s19a1k11/SmartHome_v21/串口测试命令手册.md

# 串口调试助手 测试命令手册（v22）

> 全部命令**从代码实际实现提取**，逐条核对过，可直接复制粘贴。
> 文件：`MASTER/user/api/cli.c` + `cloud.c`

---

## 一、串口设置（必须对）

| 项 | 值 | 说明 |
|---|---|---|
| 串口号 | 接 **PA9/PA10** 的那个 | 主机调试口 |
| 波特率 | **9600** | ⚠️ 不是 115200 |
| 数据位 | 8 | |
| 停止位 | 1 | |
| 校验位 | NONE | |
| **发送模式** | **ASCII** | ⚠️ 不是 HEX |
| 接收模式 | ASCII | |
| 加回车换行 | 建议勾选 | 不勾也能用（靠 IDLE 判帧） |

**发送切 HEX 会全部失败**——那是给 ModBus 原始帧调试用的。

---

## 二、本地诊断命令（`@` 开头）

### 2.1 总览类

```
@help
```
列出所有命令。**第一个该敲的命令。**

```
@version
```
打印固件版本和关键配置。预期输出：
```
[CLI] fw=2026-10-24-v21 MASTER slaves=2
[CLI] reply_timeout=250ms upload=15s modbus_log=0
```

```
@stat
```
**最常用**。打印两台从机的完整状态：
```
[CLI] ===== slaves =====
[CLI] #1 addr=1 ONLINE err=0 dErr=0
[CLI]    T=24.2 H=31.0 Lux=3719
[CLI]    LED=0 BEEP=0 SERVO=1 run=125s
[CLI] #2 addr=2 ONLINE err=0 dErr=0
[CLI]    T=26.8 H=36.0 Lux=3720
[CLI]    LED=0 BEEP=0 SERVO=1 run=98s
[CLI] SR602=0 LuxAvg=3718 Night=0 led1=0
```

### 2.2 硬件诊断类

```
@esp
```
诊断 ESP8266。会打印引脚电平 + 主动发一次 `AT` + 原始回包：
```
[CLI] CH_PD(PA4)=1 GPIO0(PA15)=1
[CLI] esp got=6B raw=[\r\nOK\r\n]
[CLI] ESP alive (got OK)
```

```
@sr602
```
人体感应状态：
```
[CLI] SR602=0 (1=human) LuxAvg=3718 Night=0
```
**手在模块前晃一下**，再敲一次应该变 `SR602=1`。

```
@lcd
```
**屏幕自检**。依次刷纯红 → 纯绿 → 纯蓝 → 恢复界面（每个 0.6 秒）。

| 现象 | 判断 |
|---|---|
| 三色都能看到 | 屏幕和接线正常 |
| 只有白/黑 | SPI 没通，查 PA5/PA7/CS/DC |

### 2.3 动作测试类

```
@poll
```
立刻轮询一次全部从机（不等 1 秒节拍），然后打印状态。

```
@upload
```
立刻上报一次云端（不等 15 秒节拍）。成功后串口会看到 `[CLOUD] up: {...}`。

```
@autolight on
```
强制打开 1 号从机的灯（绕过夜晚判定）。**测灯最直接的方法。**
```
[CLI] led1 forced ON
```

```
@autolight off
```
强制关闭 1 号从机的灯。

### 2.4 调试开关类

```
@log on
```
打开逐帧 ModBus 日志。之后每笔事务都会打原始帧：
```
TX[08]: 01 03 00 00 00 04 44 09
RX[13]: 01 03 08 01 02 00 00 00 00 00 00 77 DB
```
**⚠️ 打开后轮询会明显变慢**（实测日志吃掉约 89% 的串口带宽），调完记得关。

```
@log off
```
关闭逐帧日志，恢复正常速度。

---

## 三、模拟云端下发命令（JSON）

这些命令走的是**和云端下发完全相同**的函数 `Cloud_Handle_Downlink()`。
所以**串口能通 = 云端一定能通**。

### 3.1 灯控制（最常用）

```
{"Led1":true}
```
1 号从机开灯。预期：
```
[CLI] rx: {"Led1":true}
[CLI] -> Cloud_Handle_Downlink
[CLOUD] down: {"Led1":true}
[CLOUD] led#1 ON ok
```

```
{"Led1":false}
```
1 号从机关灯。

```
{"Led2":true}
```
2 号从机开灯。

```
{"Led2":false}
```
2 号从机关灯。

### 3.2 蜂鸣器

```
{"Beep1":true}
```
1 号蜂鸣器响。

```
{"Beep1":false}
```
1 号蜂鸣器停。

```
{"Beep2":true}
```

```
{"Beep2":false}
```

### 3.3 舵机

```
{"SG90_1":"clockwise"}
```
1 号舵机顺时针 = **180 度**（档位 2）。

```
{"SG90_1":"counter_clockwise"}
```
1 号舵机逆时针 = **0 度**（档位 0）。

```
{"SG90_2":"clockwise"}
```

```
{"SG90_2":"counter_clockwise"}
```

**也兼容数字档位**（0/1/2）：
```
{"SG90_1":0}
{"SG90_1":1}
{"SG90_1":2}
```
对应 0° / 90° / 180°。

### 3.4 总使能开关

```
{"stm32":true}
```
总使能开（默认就是开）。

```
{"stm32":false,"Led1":true}
```
总使能关 → **整条命令被忽略**，灯不会亮。预期：
```
[CLOUD] stm32 disabled, drop cmd
```
**用来验证总使能逻辑。**

### 3.5 组合命令

一条命令做多件事：
```
{"Led1":true,"Beep1":true,"SG90_1":"clockwise"}
```
```
{"Led1":false,"Led2":true,"Beep2":true}
```
```
{"stm32":true,"Led1":true,"Led2":true}
```

---

## 四、按测试目标组织的测试序列

### 测试 1：验证串口和 CLI 活着

```
@version
```
看到 `v21` 和 `slaves=2` → 通过。

### 测试 2：验证两台从机在线

```
@stat
```
看到两台都是 `ONLINE` 且温湿度光照有真实数据 → 通过。

### 测试 3：验证灯控制（1 号）

```
{"Led1":true}
```
**看 1 号从机板上的红色 LED（PB5/DS0）是否亮起。**

```
{"Led1":false}
```
灯灭 → 通过。

如果打 `[CLOUD] led#1 ON ok` 但灯不亮，是硬件问题（查从机板 LED）。

### 测试 4：验证舵机

```
{"SG90_1":"clockwise"}
```
舵机转到 180 度。

```
{"SG90_1":"counter_clockwise"}
```
舵机转到 0 度 → 通过。

### 测试 5：验证蜂鸣器

```
{"Beep1":true}
```
响。等 2 秒。

```
{"Beep1":false}
```
停 → 通过。

### 测试 6：验证总使能

```
{"stm32":false,"Led1":true}
```
预期灯**不亮**，串口打 `stm32 disabled, drop cmd`。

```
{"stm32":true,"Led1":true}
```
预期灯亮 → 通过。

### 测试 7：验证 SR602 人体感应

```
@sr602
```
记下当前值（应该 `SR602=0`）。

**手在 SR602 模块前晃 2 秒**，再敲：
```
@sr602
```
应该变 `SR602=1` → 通过。

### 测试 8：验证夜晚自动开灯

**方法 A：临时改阈值（能测完整逻辑）**

改 `MASTER/user/api/autolight.h`：
```c
#define NIGHT_LIGHT_THRESHOLD (4000)   // 临时：白天也算夜晚
```
重新编译烧录。然后：
1. 手在 SR602 前晃 → `human=1` 且 `night=1` → **灯自动亮**
2. 手拿开 → 等 **10 秒** → **灯自动灭**

日志：
```
[AUTO] human left, start timer
[AUTO] led off
```

**测完记得改回 1500。**

**方法 B：用 CLI 强制开（不测自动逻辑，只测灯）**
```
@autolight on
```

### 测试 9：验证云端上报

```
@upload
```
预期串口打出完整 JSON：
```
[CLOUD] up: {"Temp1":24.2,"Hum1":31.0,"Lux1":3719,"Led1":false,"Bp1":false,
"SenErr1":false,"Temp2":26.8,"Hum2":36.0,"Lux2":3720,"Led2":false,
"Bp2":false,"SenErr2":false,"SR602":0,"LuxAvg":3718,"Night":0,
"Online1":true,"Online2":true}
```

然后去 ThingsCloud 平台看属性面板是否刷新。

### 测试 10：验证 ModBus 原始帧

```
@log on
```
等 3 秒，会看到：
```
TX[08]: 01 03 00 00 00 04 44 09
RX[13]: 01 03 08 01 02 00 00 00 00 00 00 77 DB
```
**用 ModBus 调试工具或手册核对 CRC。**

```
@log off
```
恢复。

### 测试 11：验证屏幕

```
@lcd
```
三色 + 界面 → 通过。

### 测试 12：验证 ESP8266

```
@esp
```
预期 `got=6B raw=[\r\nOK\r\n]` + `ESP alive`。

---

## 五、错误提示对照表

| 串口输出 | 含义 | 怎么修 |
|---|---|---|
| `[CLI] not a command: need '{' (json) or '@' (local)` | 输入格式不对 | JSON 以 `{` 开头，本地命令以 `@` 开头 |
| `[CLI] unknown cmd: @xxx` | 命令名拼错 | 敲 `@help` |
| `[CLOUD] !! NO KEY MATCHED` | JSON 键名不对 | 键名**区分大小写**，用 `Led1` 不是 `LED1` |
| `[CLOUD] stm32 disabled, drop cmd` | 总使能是 false | 正常行为 |
| `[CLOUD] led#1 DROPPED: slave offline` | 从机离线 | 先 `@stat` 看在线状态 |
| `[CLOUD] led#1 ON WRITE FAIL stat=1` | ModBus 写超时 | 查 485 接线 / 从机供电 |
| `[CLOUD] led#1 ON WRITE FAIL stat=2` | CRC 错 | 总线干扰 / 没共地 |
| `[CLOUD] led#1 ON WRITE FAIL stat=6` | 从机拒绝 | 值越界（不该发生） |
| `[MB] TIMEOUT addr=N` | 从机不应答 | 该从机没上电 / 地址不对 |
| `[MB] CRC FAIL` | 收到的帧 CRC 错 | 485 干扰 / T3.5 时序 |
| `[ESP] no 'OK' got=0B` | 模块没回任何字节 | 查 PB10→RX、PB11→TX、3.3V |
| `[CLOUD] no connack` | MQTT 凭据错 | 核对用户名密码 |
| `[CLOUD] PUBLISH DROPPED!` | 报文超长 | 不该发生（缓冲 512） |

---

## 六、一次性批量测试脚本（可选）

如果串口助手支持"循环发送"或"多条发送"，可以按这个顺序配：

**批次 1（灯）**
```
{"Led1":true}
{"Led1":false}
{"Led2":true}
{"Led2":false}
```

**批次 2（舵机）**
```
{"SG90_1":"clockwise"}
{"SG90_1":"counter_clockwise"}
{"SG90_2":"clockwise"}
{"SG90_2":"counter_clockwise"}
```

**批次 3（蜂鸣器）**
```
{"Beep1":true}
{"Beep1":false}
{"Beep2":true}
{"Beep2":false}
```

**批次 4（诊断）**
```
@stat
@sr602
@upload
```

---

## 七、JSON 格式硬规则（避免失败）

### 规则 1：键名区分大小写

| ✅ 正确 | ❌ 错误 |
|---|---|
| `Led1` | `LED1`、`led1`、`LED_1` |
| `Beep1` | `BEEP1`、`beep1` |
| `SG90_1` | `sg90_1`、`SG90-1` |
| `stm32` | `STM32`、`Stm32` |

### 规则 2：布尔值必须小写

```json
{"Led1":true}      ✅
{"Led1":True}      ❌
{"Led1":TRUE}      ❌
{"Led1":1}         ✅ 也兼容
{"Led1":0}         ✅ 也兼容
```

### 规则 3：舵机字符串必须带引号

```json
{"SG90_1":"clockwise"}      ✅
{"SG90_1":clockwise}        ❌ JSON 非法
{"SG90_1":2}                ✅ 数字档位也行
```

### 规则 4：单行长度上限 160 字符

`CLI_LINE_MAX = 160`。组合命令不要太长：

```
{"Led1":true,"Beep1":true,"SG90_1":"clockwise"}       45 字符  ✅
{"Led1":true,"Led2":true,"Beep1":true,"Beep2":true,"SG90_1":"clockwise","SG90_2":"counter_clockwise"}   103 字符  ✅
```

### 规则 5：不需要加空格

```
{"Led1":true}              ✅
{"Led1": true}             ✅ 也支持（代码会跳过空格）
{ "Led1" : true }          ✅ 也支持
```

---

## 八、最常用的 5 条（记住这些就够）

```
@stat                         看两台从机状态
@sr602                        看人体感应
{"Led1":true}                 开 1 号灯
{"Led1":false}                关 1 号灯
@lcd                          屏幕自检
```

---

*生成时间：2026-10-25 12:40*
*代码来源：`MASTER/user/api/cli.c` + `cloud.c`*
*所有命令均已在实际代码中核对，可直接使用*
