s19a1k11/SmartHome_v21/代码复查_v20.md

# 代码复查报告 v20（逻辑 / 实现 / 数据大小 / 返回值 / 串口1 回显）

> 对 v19 做了逐文件复查。**发现 3 个 P0 级 bug，其中 2 个会让系统在实际运行中完全不可用。**
> 全部已修复，并用 208 项仿真测试验证。

---

## 一、P0 级问题（会导致系统不可用）

### P0-1：MQTT 报文缓冲区太小，**所有上行数据被静默丢弃**

```c
// 修复前
#define MQTT_PACKAGE_SIZE (256)
```

`MQTT_Publish_Package_Send` 里的判据：

```c
if (remaining_len + 5 > MQTT_PACKAGE_SIZE) { return; }   // 静默返回，没有任何日志
```

而本工程实际上行 JSON 长度 **306 字节**，加报文头需要 **323 字节**：

| payload | 需要报文 | 256 够吗 |
|---|---|---|
| 239 | 256 | 刚好够（临界点） |
| **306（实际值）** | **323** | **不够 → 丢弃** |
| 313 | 330 | 不够 → 丢弃 |

**后果**：设备在线、MQTT 心跳正常、订阅正常，但**云端一个字节数据都收不到**。而且日志里什么异常都没有——这是最难查的一类故障：链路全通，只有数据不见。

**为什么之前没发现**：前两轮的仿真测试里 `MQTT_Publish_Package_Send` 是桩函数，只记录 payload 字符串，没有走真实的报文组装。**测试桩把真实缺陷屏蔽了。**

**修复**：
- `MQTT_PACKAGE_SIZE` 256 → **512**（覆盖理论最大 462 + 10% 余量）
- 三个发送函数 `void` → `u8`，超长时返回 0，调用方能发现
- `cloud.c` 加 `Cloud_Publish()` 统一出口，丢弃时打 `[CLOUD] PUBLISH DROPPED! payload=N need=N max=N`
- `cloud.h` 加编译期断言：`MQTT_PACKAGE_SIZE` 装不下 `CLOUD_PAYLOAD_SIZE` 就 `#error`

实测：最大可发 payload 从 239 → **495 字节**。

### P0-2：栈溢出 —— 上报时踩坏相邻 RAM

用 `gcc -fstack-usage` 实测每个函数的栈占用：

| 函数 | 栈占用 |
|---|---|
| `Cloud_Upload_All` | **560 字节** |
| `MQTT_Publish_Package_Send` | **576 字节** |
| `Cloud_Upload_Online` | 560 字节 |

调用链 `Cloud_Upload_All` → `Cloud_Publish` → `MQTT_Publish_Package_Send`：

```
560 + 16 + 576 = 1152 字节
```

而主机栈只有 `Stack_Size = 0x400 = 1024` 字节 —— **超出 128 字节**。

**后果**：栈溢出会踩坏相邻 RAM（全局变量、堆、甚至返回地址），表现是**随机的 HardFault 或数据错乱**，而且只在"上报"这个动作发生时才出现。这类 bug 在真机上极难定位，因为崩溃点往往离真正原因很远。

**修复**（两层保险）：
1. **把大缓冲移到静态区**（`.bss`），不占栈：
   - `mqtt.c`：三个发送函数共用一块 `static u8 s_mqtt_tx_buf[512]`
   - `cloud.c`：三个上传函数共用一块 `static char s_cloud_up_buf[448]`
   - 共用是安全的：这几个函数**不会嵌套、不会重入**，都在主循环单线程里顺序调用
2. **栈 1024 → 2048**（`startup_stm32f10x_hd.s` 的 `Stack_Size 0x400 → 0x800`）

修复后实测：

| 调用链 | 修复前 | 修复后 |
|---|---|---|
| 上报链 | 1152 ★溢出 | **208** ✅ |
| 建链 | 656 | **160** ✅ |
| 下发 | 240 | **240** ✅ |

### P0-3：离线通知永久丢失

```c
// 修复前
if (g_slave[i].online != g_slave[i].online_reported)
{
    g_slave[i].online_reported = g_slave[i].online;   // ← 先置标志
    Cloud_Upload_Online();                            // ← 再发送（可能失败）
}
```

`Cloud_Upload_Online()` 可能因为两个原因根本没发出去：
- `CLOUD_UPLOAD_MIN_GAP`（8 秒最小间隔）还没到
- 报文超长（P0-1 的情况）

**后果**：`online_reported` 已经等于 `online` 了，下一轮比较"相等"→ 不再重试 → **这次离线通知永久丢失**。云端一直以为从机在线，直到 15 秒的定时上报才纠正。如果那段时间还叠加了别的上报，定时上报也可能被 MIN_GAP 挡掉——表现就是"从机断电了，云端半天不报离线"。

**修复**：只有 `Cloud_Upload_Online()` **真正返回成功**才更新 `online_reported`；失败就保留原值，下一轮自动重试。

---

## 二、P1 级问题（可维护性 / 可诊断性）

### P1-1：串口1 错误回显信息不足

你特别指出的这项，原来确实不够。对比：

| 场景 | 修复前 | 修复后 |
|---|---|---|
| 从机 CRC 错 | `[SLAVE] CRC FAIL` | `RX[08]: 01 03 01 00 00 06 3B 34`<br>`[SLAVE] CRC FAIL len=8 recv=0x343B calc=0x34C4` |
| 从机地址不匹配 | 什么都不打 | `RX[08]: 02 03 01 00 00 06 C4 07`<br>`[SLAVE] ADDR SKIP me=1 got=2` |
| 从机越界写入 | 只回异常帧 | `[SLAVE] WR VALUE REJECT addr=0x0200 val=100`<br>`[SLAVE] EXC sent code=0x0003`<br>`TX[05]: 01 86 03 02 61` |
| 从机正常应答 | 无 | `RX[08]: ...` + `TX[17]: 01 03 0C ...` |
| 主机超时 | 只有返回值 | `[MB] TIMEOUT addr=1 wait=250ms/250ms fc=0x03` |
| 主机 CRC 错 | 只有返回值 | `[MB] CRC FAIL len=8 recv=0x0000 calc=0xB252` + `RX[08]: ...` |
| 主机长度不符 | 只有返回值 | `[MB] LEN MISMATCH exp=13 got=9` |
| 主机功能码不符 | 只有返回值 | `[MB] FUNC MISMATCH exp=0x03 got=0x06` |

**为什么地址不匹配也要打日志**：三台从机接在同一条线上，每台都会看到别人的帧。如果现场发现"某台板子日志里全是别人的地址"，就说明它收到了帧但地址配错了——这是排查地址冲突的关键线索。只打地址不打断整帧，避免刷爆缓冲。

### P1-2：`LOG_HexDump` 长度格式化会打出乱码

```c
// 修复前
if(len >= 10) LOG_Chr((char)('0' + len / 10));
LOG_Chr((char)('0' + len % 10));
```

只处理了十位。一旦长度上限改到 >99，`len=100` 时会打出 `'0' + 10 = ':'` 这种乱码。

**修复**：<100 时补两位（`8` → `08`，让日志竖着看对齐），≥100 时走 `LOG_Num`。上限从 48 提到 64，截断时标 `(cut NB)`。

### P1-3：其他返回值未检查

| 位置 | 问题 | 修复 |
|---|---|---|
| `MQTT_Connect_Package_Send` | 用户名/密码过长时静默不发 | 返回 0，`Cloud_Link_Build` 打 `CONNECT packet too long!` 并返回失败 |
| `MQTT_Subscribe_Package_Send` | 同上 | 返回 0，打 `SUBSCRIBE packet too long!` |
| `Cloud_Upload_*` 系列 | `void`，调用方不知道有没有发出去 | 全部返回 `u8` |

---

## 三、P2 级（注释/文档一致性）

| 位置 | 问题 | 修复 |
|---|---|---|
| 从机 `ModBus.c` 两处注释 | 还写着"主机只等 200ms"，实际是 250ms | 改成 250ms |

---

## 四、复查确认无问题的项

这些逐项核对过，**没有问题**：

| 检查项 | 结果 |
|---|---|
| CRC-16 算法与手册 23 条帧 | 全部一致 |
| 寄存器区段边界（`0x0000~0x0003` / `0x0100~0x0105` / `0x0200~0x0202`） | 正确，跨区读被拒 |
| `ModBus_RegRange_Ok` 用 u32 防回绕 | 正确 |
| 从机应答缓冲区 `resp[5+6*2+2]` = 19 字节，最长用 17 | 够 |
| 主机 `s_reply[128]` vs `USART2_BUFFER_SIZE` = 128 | 够（最长应答 17） |
| `usart2_value.count` 边界保护 | 两处都有 |
| 温度拼接 `%u.%01u` | 小数寄存器 0~9 时正确 |
| JSON 尾部逗号处理 | `,}` 检查通过 |
| `Cloud_Append_*` 每次 append 前查余量 | 正确 |
| `autolight` 除零保护（`n==0` 返回 0xFFFF） | 正确 |
| `Tick_Take` / `SR602_Take_Changed` 关中断保护 | 正确 |
| 所有 ISR 无阻塞调用（12 个 ISR 扫描） | 全部 NONE |
| PD7 只在 `485_PD7.c`（从机）/ `rs485.c`（主机） | 审计通过 |
| 中断优先级符合"收>发 / SR602 次之" | 符合 |
| `MODBUS_REPLY_TIMEOUT` 250ms vs 理论最坏 70ms | 3.6 倍余量 |
| 上报间隔 15s > 10s 下限 | 符合 |

---

## 五、验证记录

### 5.1 编译

```
从机 16 个 .c：0 失败 / 0 警告
主机 18 个 .c：0 失败 / 1 警告（mqtt.c 原有的符号比较，与本次无关）
```

### 5.2 测试（三轮共 208 项，全过）

| 轮次 | 项数 | 内容 |
|---|---|---|
| 第一轮 | 110 | 协议、异常路径、离线判定、端到端、JSON |
| 第二轮 | 58 | 夜晚开灯、TIM4 节拍、日志缓冲、超时、上报内容 |
| **第三轮（本轮新增）** | **40** | MQTT 容量、reported 重试、错误回显、长度格式化 |

第三轮关键验证：

```
======== A. MQTT 报文容量 ========
  MQTT_PACKAGE_SIZE = 512
  payload=306 -> 返回 1 (发出)        ✅ 修复前会被静默丢弃
  真实上报 JSON 长度 = 310, 需要 327 字节 ✅
  payload=600 (超长) -> 返回 0         ✅ 不再静默
  实测最大可发 payload = 495 字节      ✅ 覆盖 448

======== B. 在线状态翻转的重试 ========
  第 1 次尝试被 MIN_GAP 挡下 -> 返回 0
  ★ reported 仍是 1 (没被提前更新)    ✅ 修复前会永久丢失
  过了 MIN_GAP 后上报成功              ✅
  云端收到 Online2 = false             ✅
  上报成功后才更新 reported = 0        ✅
  再调一次: 没有变化, 不重复发          ✅

======== C. 串口1 错误回显 ========
  从机 CRC 错: 原始帧 + recv/calc CRC + 长度  ✅
  从机地址不符: me/got 都打出来              ✅
  从机越界写: 地址 + 值 + 异常码 + 异常帧原始字节 ✅
  从机正常应答: RX + TX 原始帧               ✅
  主机 CRC 错: 原始帧 + recv/calc CRC        ✅

======== D. LOG_HexDump 长度格式化 ========
  长度 8 -> T[08]        ✅
  长度 17 -> T[17]       ✅
  长度 100 -> T[64] + (cut 36B)  ✅
```

### 5.3 栈占用实测

```
修复前: Cloud_Upload_All(560) -> MQTT_Publish(576) = 1152 > 1024  ★溢出
修复后: Cloud_Upload_All(112) -> MQTT_Publish(80)  =  208 < 2048  ✅ 余量 1840
```

### 5.4 ISR 静态扫描

```
从机 6 个 ISR：全部 NONE
主机 6 个 ISR：全部 NONE
```

---

## 六、改动文件清单（相对 v19）

### 主机

| 文件 | 改动 |
|---|---|
| `api/mqtt.h` | `MQTT_PACKAGE_SIZE` 256→**512**；三个发送函数返回 `u8`；加 `MQTT_PAYLOAD_MAX` |
| `api/mqtt.c` | 报文缓冲改 `static s_mqtt_tx_buf[512]`（省栈）；三个函数返回成功/失败 |
| `api/cloud.h` | `Cloud_Upload_*` 返回 `u8`；加 `MQTT_PACKAGE_SIZE` 编译期断言 |
| `api/cloud.c` | payload 改 `static s_cloud_up_buf[448]`（省栈）；新增 `Cloud_Publish()` 统一出口；`online_reported` 改成功后才更新；建链检查 CONNECT/SUBSCRIBE 返回值 |
| `api/modbus.c` | `Check_Reply` 打全 recv/calc CRC、地址、功能码；超时打 wait/上限/fc；TX 原始帧回显；长度/功能码不符都打具体值 |
| `api/log.c` | `LOG_HexDump` 长度格式化修乱码；上限 48→64；截断标 `(cut NB)` |
| `libraries/CMSIS/startup/startup_stm32f10x_hd.s` | `Stack_Size` 0x400 → **0x800** |

### 从机

| 文件 | 改动 |
|---|---|
| `api/ModBus.c` | 无条件回显 RX/TX 原始帧；CRC 错打 len+recv+calc；地址不符打 me/got；越界写打 addr+val；异常帧打 code；注释 200ms→250ms |
| `api/log.c` | 同主机（`LOG_HexDump` 修复） |

---

## 七、这次复查暴露的方法问题

**测试桩会屏蔽真实缺陷。** P0-1（MQTT 容量）和 P0-2（栈溢出）都是因为测试里 `MQTT_Publish_Package_Send` 被替换成桩函数，真实的报文组装代码根本没跑过。

第三轮把 **真实的 `mqtt.c` 链进测试**，并直接从 USART3 的字节流里解出 PUBLISH 报文验证，才暴露出容量问题。

**教训**：仿真测试里凡是"桩掉了一个有容量/边界逻辑的函数"，就必须单独补一个用真实实现的测试。桩只适合替换纯硬件操作（GPIO/寄存器），不适合替换"有数据搬运和边界判断"的业务函数。

---

## 八、现场建议

1. **先确认 P0-1 的修复生效**：烧录后看串口有没有 `[CLOUD] up: {...}`，云端属性面板是否开始更新。如果还是没数据，看有没有 `PUBLISH DROPPED` 日志。
2. **栈已加到 2048**：如果以后再加大的局部数组，记得用 `-fstack-usage` 复核（本次就是靠它发现的溢出）。
3. **错误回显现在会打原始帧**：调试时把串口助手切到文本模式即可看到 `RX[08]: 01 03 ...` 这样的行，可以直接和手册逐字节对照。
