s19a1k11/SmartHome_v21/说明_v21.md

# v21：串口1 模拟 MQTT 指令 + 复查修正

> 两件事：
> 1. **能，已经做好了** —— 主机串口1 现在可以直接接收串口助手发来的 JSON 命令，走的是和云端下发**完全相同**的函数。
> 2. **我不能说"没有 bug"** —— 这轮复查又发现了我自己在上一轮引入的一个严重性能回归，已修。

---

## 一、串口1 模拟 MQTT 指令（新功能）

### 1.1 怎么用

串口助手：**9600 8N1**，发送时勾选"加回车换行"（不加也行，用 IDLE 判帧）。

直接敲 JSON，和云端下发的格式一模一样：

```
{"Led1":true}                        开 1 号从机的灯
{"Led1":false}                       关 1 号从机的灯
{"Beep1":true}                       1 号蜂鸣器响
{"SG90_1":"clockwise"}               1 号舵机顺时针（180 度）
{"SG90_1":"counter_clockwise"}       1 号舵机逆时针（0 度）
{"Led1":true,"Beep1":true}           一条命令做多件事
{"stm32":false,"Led1":true}          总使能关闭 → 整条命令被忽略
```

执行后会自动回读一次并打印三台从机的状态，所以敲完立刻能看到结果：

```
[CLI] rx: {"Led1":true}
[CLI] -> Cloud_Handle_Downlink
[CLOUD] down: {"Led1":true}
[CLI] ===== slaves =====
[CLI] #1 addr=1 ONLINE err=0 dErr=0
[CLI]    T=28.3 H=52.0 Lux=1420
[CLI]    LED=1 BEEP=0 SERVO=1 run=75s
[CLI] #2 addr=2 OFFLINE err=2 dErr=2
[CLI] #3 addr=3 OFFLINE err=2 dErr=2
[CLI] SR602=0 LuxAvg=65535 Night=0 led1=1
```

### 1.2 关键点：走的是同一条代码路径

```
串口1 CLI ──┐
            ├──> Cloud_Handle_Downlink()  ──> JSON 解析 ──> ModBus 写从机 ──> 回读 ──> 上报
MQTT 下行 ──┘
```

所以**用串口模拟通了，接上云平台就一定通**（除非 MQTT 传输层本身有问题）。这样在实验室调从机、调舵机方向、调自动开灯时，不用每次都去平台上点按钮。

### 1.3 额外的本地诊断命令

这些不是 JSON，以 `@` 开头（不会和云端命令冲突）：

| 命令 | 作用 |
|---|---|
| `@help` | 列出所有命令 |
| `@stat` | 打印三台从机完整状态（在线/温湿度/光照/灯/蜂鸣器/舵机/运行秒数） |
| `@poll` | 立刻轮询一次全部从机（不等 1 秒节拍） |
| `@upload` | 立刻上报一次云端（不等 15 秒节拍） |
| `@autolight on` / `off` | 强制开关 1 号从机的灯（绕过夜晚判定，测试用） |
| `@sr602` | 打印 SR602 状态 + 平均光照 + 夜晚判定 |
| `@log on` / `off` | **运行时**打开/关闭逐帧 ModBus 日志（不用重新编译） |
| `@version` | 打印固件版本和关键配置 |

### 1.4 为什么用 `@` 前缀区分

云端下发永远是 JSON（以 `{` 开头）。用 `@` 开头就不会有歧义，也不会出现"敲错一个字符被当成 JSON 解析"的情况。

### 1.5 实现约束（和整个工程一致）

- 解析在**主循环**（`CLI_Poll`），不在中断里
- 所有输出走 `LOG_*` 进缓冲，由 main 循环最后一步统一 Flush
- 不阻塞轮询：一帧处理完立刻返回
- 用 IDLE 判帧，不依赖对方发换行符
- 有去重：同一条命令不会因为 IDLE 多次触发而被执行两次

---

## 二、这轮复查发现的问题

### P0：我上一轮引入的严重性能回归

上一轮为了"回显完整"，我在 `ModBus_Check_Reply` 里把原始帧回显加到了**正常路径**（无条件 `LOG_HexDump`）。实测代价：

```
每笔事务 TX+RX ≈ 95 字符
一轮轮询（3 台 × 3 笔）= 855 字符
9600 下 = 891 ms
轮询周期 = 1000 ms
→ 日志吃掉 89% 的周期
```

**后果**：主循环被严重拖慢，MQTT 心跳和云端下行都得不到及时处理，上报节拍漂移。

**修复**：正常路径静默，出错路径无条件回显。

| 场景 | 修复前 | 修复后 |
|---|---|---|
| 正常事务 | 打 95 字符/笔 | **0 字符** |
| 一轮轮询日志量 | 855 字节 | **96 字节** |
| 换算耗时 | 891 ms | **100 ms** |

为什么保留"出错时无条件打"：出错是低频事件，几行日志换一个可定位的线索，值得。正常路径才是高频的，那里必须静默。

### P1：`@log on` 之后看不到 RX 帧

`ModBus_Check_Reply` 里 RX 回显原来只放在 CRC 失败分支里，所以打开逐帧日志后只能看到 TX、看不到 RX，调试时缺一半信息。

**修复**：先用开关判断一次覆盖正常路径；出错路径再无条件补打（且不重复）。

### P2：清掉全部编译警告

- `cli.c` 的 `unused parameter 'len'`
- `mqtt.c` 的 `signed/unsigned` 比较（原有代码，顺手修）

现在**两个工程 0 失败 0 警告**。

---

## 三、"现在确定没什么 BUG 了吗"

**不能这么说。** 我这几轮的实际情况是：

- 第 3 轮我说"查完了"，第 4 轮又发现自己上一轮引入的 89% 性能回归
- 第 3 轮发现的 2 个 P0（MQTT 容量、栈溢出），都是**测试桩屏蔽真实代码**导致的
- 每次"再查一遍"都还能查出东西

所以准确的说法是：

**已修复并验证的部分**（259 项测试 + 全量编译 + 静态审计）：
- 协议层：CRC、寄存器映射、异常路径、边界保护
- 数据大小：所有缓冲区、计数器、栈占用（实测）
- 返回值：MQTT 发送、云端上传、ModBus 事务全部检查
- 中断：12 个 ISR 全部快进快出（脚本扫描函数体）
- 并发：共享变量关中断保护
- 性能：日志量实测、轮询周期占用

**不能保证的部分**：
- **真机时序**：仿真测不出真实的 485 电气特性、中断延迟、DHT11 时序余量。这些必须上板测。
- **云平台交互**：平台的流控阈值、物模型类型校验、QoS 行为，只有真连才知道。
- **长时间运行**：49 天计时回绕、内存碎片、Flash 寿命，仿真跑不出来。
- **我自己的盲区**：第 3、4 轮都是我自己引入又自己发现的，说明**我的复查有盲点**，尤其是"改动对性能的二次影响"这类。

建议上板后重点验证：① 云端能否收到数据（P0-1 修复是否生效）② 连续运行几小时看有没有 HardFault（P0-2 栈）③ 三台从机断电/恢复的离线判定 ④ 串口1 CLI 各命令。

---

## 四、验证记录

### 4.1 编译

```
从机 16 个 .c：0 失败 / 0 警告
主机 19 个 .c：0 失败 / 0 警告
```

### 4.2 测试（四轮共 259 项，全过）

| 轮次 | 项数 | 内容 |
|---|---|---|
| 第一轮 | 110 | 协议、异常路径、离线判定、端到端、JSON |
| 第二轮 | 58 | 夜晚开灯、TIM4 节拍、日志缓冲、超时、上报内容 |
| 第三轮 | 39 | MQTT 容量、reported 重试、错误回显、长度格式化 |
| **第四轮（本轮）** | **52** | **串口1 CLI、日志开关、性能回归、边界安全** |

第四轮关键验证：

```
======== A. JSON 命令（和云端同一条路径） ========
  {"Led1":true}  -> 从机 g_led=1，主机回读=1        ✅
  走了 Cloud_Handle_Downlink（和云端同一个函数）     ✅
  {"Led1":false} / 舵机双向 / 蜂鸣器 / 多命令       ✅
  {"stm32":false,...} -> 整条命令被忽略             ✅

======== B. 本地诊断命令 ========
  @help / @version / @stat / @sr602 / @poll        ✅
  @autolight on/off                                 ✅
  未知命令 / 非法输入 / 空行 都有正确提示            ✅

======== C. 逐帧日志开关 ========
  默认关闭：正常事务完全静默（0 字符）              ✅
  @log on：能看到 TX[08] 和 RX[13]                  ✅
  @log off：恢复静默                                ✅

======== D. 性能回归 ========
  一轮轮询日志量 = 96 字节（修复前 855）            ✅
  换算耗时 = 100ms（修复前 891ms）                  ✅

======== E. 边界安全 ========
  255 字节超长输入不崩溃                            ✅
  一条命令只执行一次（重复 Poll 不重复执行）         ✅
```

### 4.3 ISR 审计

```
从机 6 个 ISR：全部 OK
主机 6 个 ISR：全部 OK
```

---

## 五、改动文件清单（相对 v20）

| 文件 | 改动 |
|---|---|
| `api/cli.h` / `cli.c` | **新增**，串口1 本地命令解析（JSON + @ 命令），约 430 行 |
| `api/modbus.c` | 正常路径回显改为受 `CLI_Get_ModBus_Log()` 控制；出错路径无条件回显；RX 回显移出 CRC 失败分支 |
| `api/modbus.h` | `MODBUS_LOG` 注释更新，说明运行时开关 |
| `main.c` | `CLI_Init()` + 主循环最前面加 `CLI_Poll()` |
| `project/*.uvprojx` | 加入 `cli.c` / `cli.h` |
| `api/mqtt.c` | 清掉 signed/unsigned 比较警告 |
| 从机 `api/ModBus.c` | 正常路径回显改为 `#if MODBUS_SLAVE_LOG`；出错路径无条件；地址不匹配日志加限流 |

**备份**：`_bak2_20261024-153143\{slave,master}`（第二轮前）、`_bak_20261024-143556\{slave,master}`（第一轮前）

---

## 六、串口1 现在承担两个角色

注意这一点，别混淆：

| 角色 | 方向 | 说明 |
|---|---|---|
| **调试日志输出** | 主机 → 电脑 | 所有 `LOG_*` 内容，主循环最后一步统一 Flush |
| **本地命令输入** | 电脑 → 主机 | 本版新增，JSON 模拟云端下发 + `@` 诊断命令 |

两者共用一个串口但**不会冲突**：收和发是独立的物理通道（PA9 发 / PA10 收）。串口助手里能同时看到日志输出、也能往下发命令。

唯一的注意点：日志量大的时候（比如 `@log on`）串口助手的接收区会刷得很快，但**不影响命令发送**。
