s19a1k11/SmartHome_v21/云平台配置清单.md

# ThingsCloud 完整物模型配置清单（v21，全部属性）

> 依据：`MASTER/user/api/cloud.c` 实际代码逐行提取。
> 平台类型只认 ThingsCloud 的 6 种基本类型：**Number / Text / Switch / Enum / Object / List**
> 官方文档明确：**Number 不区分整数和浮点**，所以 `31.7` 和 `3712` 都用 Number。

---

## 一、全部属性总表（20 个）

| # | 标识符 | 类型 | 权限 | 名称建议 | 说明 |
|---|---|---|---|---|---|
| 1 | `Temp1` | **Number** | 读 | 1号温度 | ℃，一位小数 |
| 2 | `Hum1` | **Number** | 读 | 1号湿度 | %RH，一位小数 |
| 3 | `Lux1` | **Number** | 读 | 1号光照 | 0~4095 |
| 4 | `Led1` | **Switch** | **读+写** | 1号灯 | 上报真实状态，也接受下发 |
| 5 | `Bp1` | **Switch** | **读+写** | 1号蜂鸣器 | 上报状态，也接受下发 |
| 6 | `SenErr1` | **Switch** | 读 | 1号传感器异常 | true=连续2次采集失败 |
| 7 | `Temp2` | **Number** | 读 | 2号温度 | ℃ |
| 8 | `Hum2` | **Number** | 读 | 2号湿度 | %RH |
| 9 | `Lux2` | **Number** | 读 | 2号光照 | 0~4095 |
| 10 | `Led2` | **Switch** | **读+写** | 2号灯 | |
| 11 | `Bp2` | **Switch** | **读+写** | 2号蜂鸣器 | |
| 12 | `SenErr2` | **Switch** | 读 | 2号传感器异常 | |
| 13 | `SR602` | **Number** | 读 | 人体感应 | 主机侧，0/1 |
| 14 | `LuxAvg` | **Number** | 读 | 平均光照 | 主机侧，0~4095 |
| 15 | `Night` | **Number** | 读 | 是否夜晚 | 主机侧，0/1 |
| 16 | `Online1` | **Switch** | 读 | 1号在线 | |
| 17 | `Online2` | **Switch** | 读 | 2号在线 | |
| 18 | `stm32` | **Switch** | **读+写** | 总使能 | false=忽略整条下发命令 |
| 19 | `SG90_1` | **Enum** | **读+写** | 1号舵机 | 枚举项见下 |
| 20 | `SG90_2` | **Enum** | **读+写** | 2号舵机 | 枚举项见下 |

### 按类型统计

| 类型 | 数量 | 标识符 |
|---|---|---|
| **Number** | **9** | `Temp1` `Hum1` `Lux1` `Temp2` `Hum2` `Lux2` `SR602` `LuxAvg` `Night` |
| **Switch** | **9** | `Led1` `Bp1` `SenErr1` `Led2` `Bp2` `SenErr2` `Online1` `Online2` `stm32` |
| **Enum** | **2** | `SG90_1` `SG90_2` |
| **合计** | **20** | |

---

## 二、Enum 类型的枚举项（必须照抄）

| 标识符 | 枚举项 | 含义 |
|---|---|---|
| `SG90_1` / `SG90_2` | `clockwise` | 顺时针（从机档位 2 = 180 度） |
| | `counter_clockwise` | 逆时针（从机档位 0 = 0 度） |

**必须是小写 + 下划线**，代码里是 `strcmp(text, "clockwise")` 精确匹配。

---

## 三、逐条注意点

### 1. `Led1/2` 和 `Bp1/2` 权限必须是「读+写」

代码里这几个键**双向使用**：

```c
// 上报
sprintf(key, "Led%d", index + 1);
Cloud_Append_Bool(payload, ..., key, dev->led, 0);

// 下发
sprintf(key, "Led%d", index + 1);
if (JSON_GetBool(payload, key, &val)) Cloud_Write_LED(index, val);
```

只配「只读」→ 上报能通，但平台下发时被拒。

### 2. Number 类型不要设最小/最大值

官方文档：

> 当设置数值属性的最大值或最小值后，如果上报或下发的数值属性不符合该条件，ThingsCloud 会**拒绝处理**

建议**全部不设范围**。理由：
- `Hum1` 实测出现过 `9.0`（DHT11 量程外），设了 20~90 会被拒
- 设范围属于额外风险，不设最省事

### 3. Switch 的值类型选项

官方文档说 Switch 支持三种值类型：

| 选项 | JSON 写法 |
|---|---|
| 布尔 | `true` / `false` ← **选这个** |
| 整数 | `1` / `0` |
| 文本 | `ON` / `OFF` |

代码发的是 `true`/`false`，所以选**布尔**。

### 4. 可以删掉的旧属性

| 标识符 | 原因 |
|---|---|
| `SR602_1` / `SR602_2` / `SR602_3` | v21 不再上报（SR602 移到主机，改单值 `SR602`） |

保留不影响（不更新，界面显示旧值），想干净就删。

### 5. 第三台从机的属性先不用配

现在 `SLAVE_NUM = 2`，代码**不会发** `Temp3` / `Hum3` / `Lux3` / `Led3` / `Bp3` / `SenErr3` / `Online3`。

以后接第三块板时，把 `SLAVE_NUM` 改回 3，再补配这 7 个：
`Temp3` `Hum3` `Lux3` `Led3`(读写) `Bp3`(读写) `SenErr3` `Online3`

---

## 四、MQTT 上报的三种 JSON（代码实测）

### ① 定时上报（每 15 秒，大包）

Topic：`attributes`，**221 字节**

```json
{"Temp1":31.7,"Hum1":10.0,"Lux1":3712,"Led1":false,"Bp1":false,"SenErr1":false,
 "Temp2":27.2,"Hum2":35.0,"Lux2":3720,"Led2":false,"Bp2":false,"SenErr2":false,
 "SR602":0,"LuxAvg":3716,"Night":0,"Online1":true,"Online2":true}
```

### ② 在线状态变化（即时，小包）

Topic：`attributes`，**31 字节** ← 这是你目前唯一能成功到达平台的

```json
{"Online1":true,"Online2":true}
```

### ③ 单台从机（云端下发后回读触发）

Topic：`attributes`，**78 字节**

```json
{"Temp1":31.7,"Hum1":10.0,"Lux1":3712,"Led1":true,"Bp1":false,"SenErr1":false}
```

---

## 五、值类型对照（决定平台选什么）

| 键 | 代码发的值 | JSON 里是什么 | 平台选 |
|---|---|---|---|
| `Temp1` | `31.7` | 浮点数字 | **Number** |
| `Hum1` | `10.0` | 浮点数字 | **Number** |
| `Lux1` | `3712` | 整数 | **Number** |
| `Led1` | `false` | 布尔 | **Switch** |
| `Bp1` | `false` | 布尔 | **Switch** |
| `SenErr1` | `false` | 布尔 | **Switch** |
| `SR602` | `0` | 整数 | **Number** |
| `LuxAvg` | `3716` | 整数 | **Number** |
| `Night` | `0` | 整数 | **Number** |
| `Online1` | `true` | 布尔 | **Switch** |
| `SG90_1` | `"clockwise"` | 字符串 | **Enum** |

---

## 六、云端下发格式

Topic：`attributes/push`

```json
{"stm32":true,"Led1":true,"Beep2":false,"SG90_1":"clockwise"}
```

| 键 | 值 | 作用 |
|---|---|---|
| `stm32` | `true`/`false` | 总使能，false 时整条忽略 |
| `Led1` / `Led2` | `true`/`false` | 开关灯 |
| `Beep1` / `Beep2` | `true`/`false` | 蜂鸣器 |
| `SG90_1` / `SG90_2` | `"clockwise"` / `"counter_clockwise"` | 舵机方向 |

键可以只写一部分，缺省的表示不改动该外设。

---

## 七、配置完验证

1. 保存物模型
2. 等 15 秒
3. 看平台设备**属性面板** —— 17 个上报属性应该全部开始刷新

### 如果还不动

串口助手（**9600 ASCII**）敲：

```
@upload
```

- 打出 `[CLOUD] up: {"Temp1":...}` → 发送端正常，问题在平台属性配置
- 打出 `[CLOUD] PUBLISH DROPPED! payload=N need=N max=512` → 报文超长

---

## 八、常见配置错误对照

| 现象 | 原因 |
|---|---|
| 小包（Online）能通、大包不动 | 大包里有平台未定义的属性 |
| 某个属性一直不变、其他正常 | 该属性类型配错（比如 Number 配成 Switch） |
| 全部属性都不动 | 设备类型没关联到设备，或物模型没保存 |
| 下发命令无效 | 对应属性权限是「只读」 |
| 舵机下发无效 | 枚举项没配，或值拼错（必须 `clockwise` 全小写） |

---

*生成时间：2026-10-24 20:32*
*代码来源：`MASTER/user/api/cloud.c`*
*平台：ThingsCloud（接入点见 cloud_credentials.h）*
