s19a1k11/SmartHome_v21/SLAVE/user/api/all.h

#ifndef ALL_H
#define ALL_H

#include "Led.h"
#include "delay.h"
#include "beep.h"
#include "common.h"
#include "DHT11.h"
#include "servo.h"
#include "adc.h"
#include "log.h"
#include "usart1.h"
#include "usart3.h"
#include "TIM.h"
#include "type.h"
#include "USART2_485.h"
#include "485_PD7.h"
#include "GPIO_Init_One.h"
#include "ModBus.h"

#endif
