s19a1k11/SmartHome_v21/SLAVE/user/api/delay.c

#include "delay.h"

/**
	us 为用户期望延时的微秒
*/
void delay_us(u32 us)
{
		while (us--)   // __NOP 为系统中无意义的空等函数，一次 13.88 纳秒
	{
		__NOP();__NOP();__NOP();__NOP();__NOP();__NOP();__NOP();__NOP();__NOP();__NOP();
		__NOP();__NOP();__NOP();__NOP();__NOP();__NOP();__NOP();__NOP();__NOP();__NOP();
		__NOP();__NOP();__NOP();__NOP();__NOP();__NOP();__NOP();__NOP();__NOP();__NOP();
		__NOP();__NOP();__NOP();__NOP();__NOP();__NOP();__NOP();__NOP();__NOP();__NOP();
		__NOP();__NOP();__NOP();__NOP();__NOP();__NOP();__NOP();__NOP();__NOP();__NOP();
		__NOP();__NOP();__NOP();__NOP();__NOP();__NOP();__NOP();__NOP();__NOP();__NOP();
		__NOP();__NOP();__NOP();__NOP();__NOP();__NOP();__NOP();__NOP();__NOP();__NOP();
		__NOP();__NOP();
	}
	
}

/**
	ms 为用户期望延时的毫秒
*/
void delay_ms(u32 ms)
{
		while(ms--)
		{
			delay_us(1000);
		}
}
